huanghongxin886/power-calc-board/hardware/photos/board-01.jpg

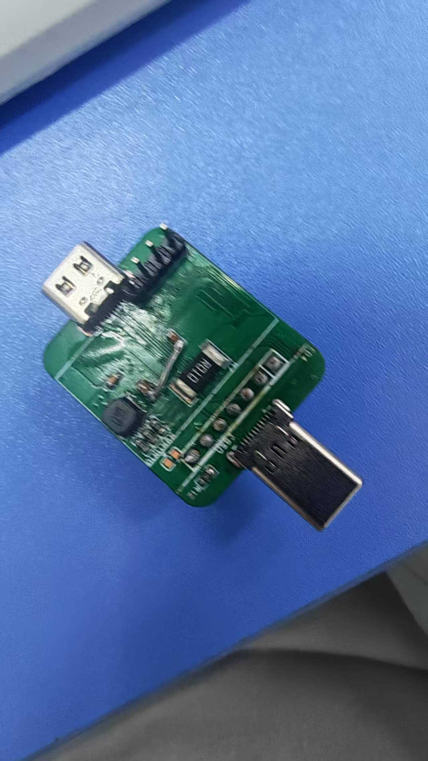
hardware/photos/board-01.jpg
