huanghongxin886/power-calc-board/hardware/render/pcb-preview.png

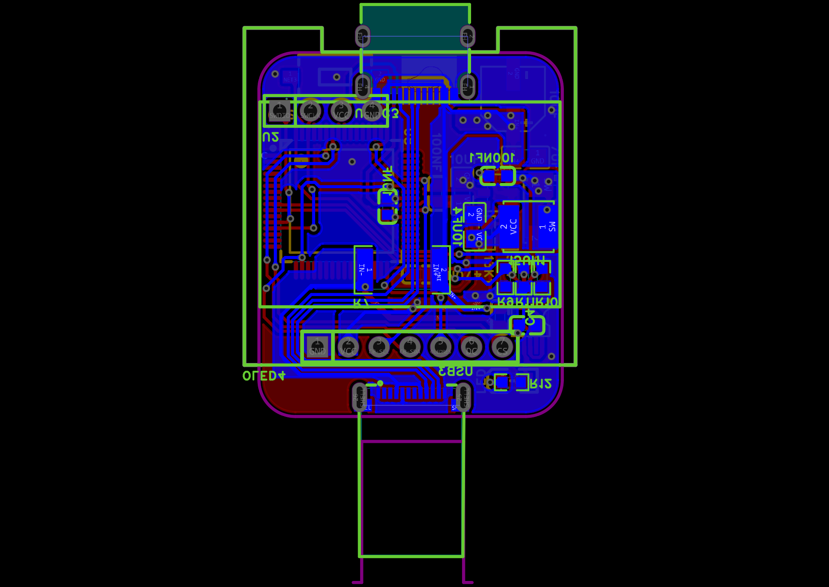
hardware/render/pcb-preview.png
