huanghongxin886/power-calc-board/firmware/OLED版_0.96寸/OLED.h

#ifndef __OLED_H
#define __OLED_H

#include <stdint.h>
#include "ti_msp_dl_config.h"
#include "OLED_Data.h"

/*参数宏定义*********************/

/*FontSize参数取值*/
/*此参数值不仅用于判断，而且用于计算横向字符偏移，默认值为字体像素宽度*/
#define OLED_8X16				8
#define OLED_6X8				6

/*********************参数宏定义*/


/*函数声明*********************/

/*初始化函数*/
void OLED_Init(void);

/*更新函数*/
void OLED_Update(void);

/*显存控制函数*/
void OLED_Clear(void);
void OLED_ClearArea(int16_t X, int16_t Y, uint8_t Width, uint8_t Height);

/*显示函数*/
void OLED_ShowImage(int16_t X, int16_t Y, uint8_t Width, uint8_t Height, const uint8_t *Image);
void OLED_ShowChar(int16_t X, int16_t Y, char Char, uint8_t FontSize);
void OLED_ShowString(int16_t X, int16_t Y, const char *String, uint8_t FontSize);
void OLED_Printf(int16_t X, int16_t Y, uint8_t FontSize, const char *format, ...);

/*********************函数声明*/

#endif
