huanghongxin886/power-calc-board/(commit log)

2026-10-20 chore: 初始化仓库骨架
    README 汇总板子关键信息、已排除项、待查量与已知设计问题；.gitignore 排除解包产物。
2026-10-20 feat(hardware): 导入工程、7 份历史备份、实物照片与预览图
    工程 .eprj2 为加密 SQLite；连接性分析走 backups/*.epro2(zip→明文 .epru)。附 hardware/README.md 说明时间线与比对方法。
2026-10-20 feat(tools): 加入 eprj_tool.py（解包/提网表/提 PCB 铜箔）
    仅标准库。记录坐标变换校准方法与实现坑点。
2026-10-20 chore(data): 加入工具产出的原理图网表与 PCB 铜箔报告
    sch_netlist.txt(105 net)、pcb_copper_report.txt、eprj2_tables.txt，均由 tools/eprj_tool.py 从 10-19 备份生成。
2026-10-20 docs: 加入 J-Link 下载失败的诊断报告与网表/铜箔证据
    结论：SWD 走线与供电已排除；重点转向 VCORE / NRST / 排针脚序 / 3.3V 分压。附三处设计缺陷（U2-GND 无走线、NRST 无上拉、FB 环与分压不一致）。
2026-10-20 docs: README 插入实物照片与原理图预览
2026-10-20 feat(tools): 加入 make_site.py 离线浏览页与 ssh 包装脚本
    make_site.py 生成单文件自包含 HTML 浏览页；ssh_gh.cmd 绕开沙箱下 MSYS sh 起不来的问题（配合 ssh.github.com:443 推送）。
2026-10-20 feat(firmware): 导入 MSPM0G3507 Keil 工程（1.9寸 TFT 主工程 + 0.96寸 OLED）
    TFT: ai_m0_gai.uvprojx + hw_lcd/ina228/board_pins/lcdfont；OLED: OLED版_0.96寸 独立工程。保留 .uvoptx 与 JLinkSettings.ini（探头序列号 / SWD 速率 / 烧录算法都在里面），排除 Objects 与编译产物、厂商 PDF。
2026-10-20 docs: 写入已确认根因（ARM-OB 克隆探头不兼容 MSPM0G3507）
    README 增加根因对比表与解决办法、firmware 章节；诊断报告顶部标注根因，原待查项归为改版隐患。
